burgrp/hw-at32f455-bob/board/at32f455-bob.kicad_pcb

## KiCad design board/at32f455-bob.kicad_pcb (2026-09-07)

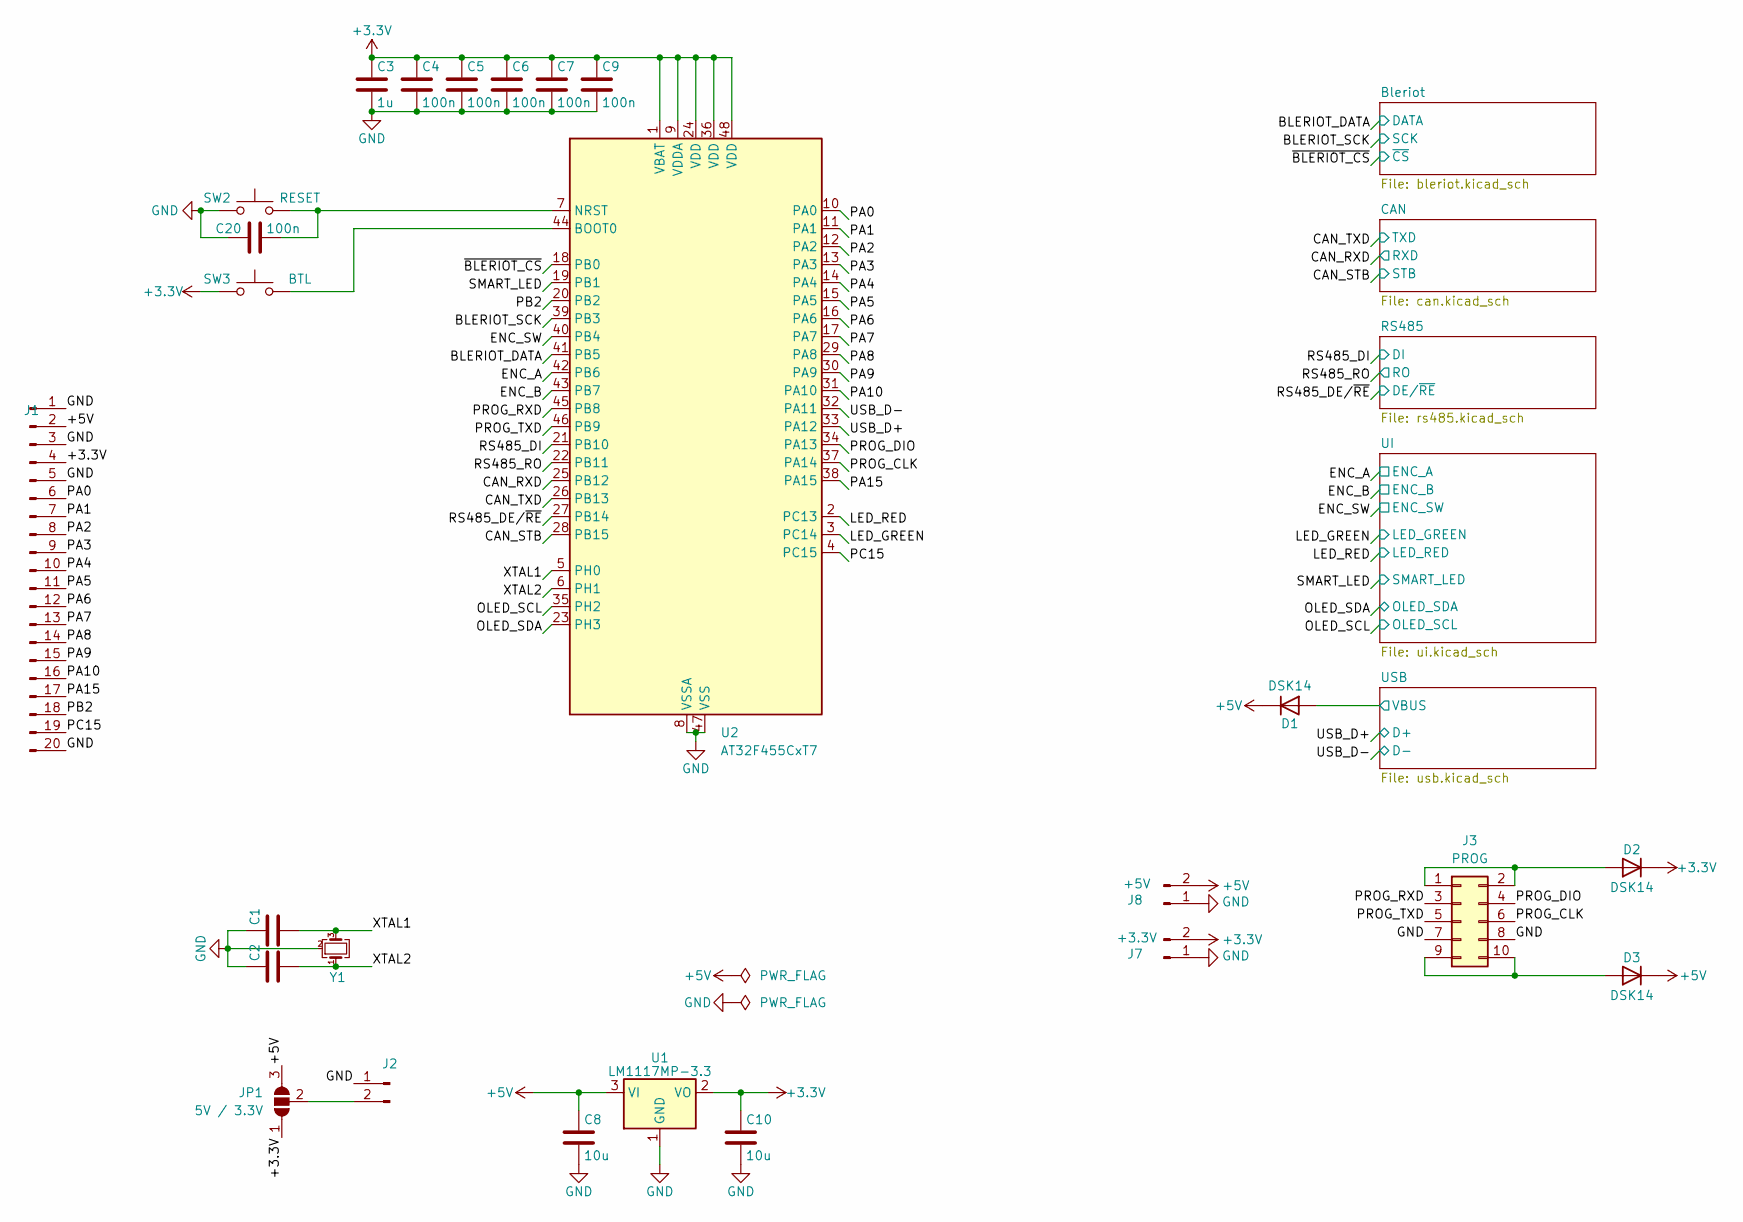
[picture p2: schematic at32f455-bob.kicad_sch]

Parts:
C1, C2: (mcu xtal load); C_0805_2012Metric
C3: 1u; C_0805_2012Metric
C4, C5, C6, C7, C9, C20: 100n; C_0805_2012Metric
C8, C10: 10u; C_0805_2012Metric
D1, D2, D3: DSK14; D_SOD-123
J1: BB; PinHeader_1x26_P2.54mm_Vertical
J2: PWR; PinHeader_1x02_P2.54mm_Vertical
J3: PROG; PinHeader_2x05_P2.54mm_Vertical
J7: +3.3V; PhoenixContact_MC_1,5_2-G-3.5_1x02_P3.50mm_Horizontal
J8: +5V; PhoenixContact_MC_1,5_2-G-3.5_1x02_P3.50mm_Horizontal
JP1: 5V / 3.3V; SolderJumper-3_P2.0mm_Open_TrianglePad1.0x1.5mm
SW2: RESET; SW_PUSH_6mm
SW3: BTL; SW_PUSH_6mm
U1: LM1117MP-3.3; SOT-223-3_TabPin2
U2: AT32F455CxT7; LQFP-48_7x7mm_P0.5mm
Y1: not populated; Crystal_SMD_3225-4Pin_3.2x2.5mm

Connections:
+3.3V: C3.1, C4.1, C5.1, C6.1, C7.1, C9.1, C10.1, D2.1 (K), J1.4, J7.2, JP1.1 (A), SW3.1, U1.2 (VO), U2.1 (VBAT), U2.9 (VDDA), U2.24 (VDD), U2.36 (VDD), U2.48 (VDD); also elsewhere on the board
+5V: C8.1, D1.1 (K), D3.1 (K), J1.2, J8.2, JP1.3 (B), U1.3 (VI); also elsewhere on the board
/BLERIOT_DATA: U2.41 (PB5); also elsewhere on the board
/BLERIOT_SCK: U2.39 (PB3); also elsewhere on the board
/CAN_RXD: U2.25 (PB12); also elsewhere on the board
/CAN_STB: U2.28 (PB15); also elsewhere on the board
/CAN_TXD: U2.26 (PB13); also elsewhere on the board
/ENC_A: U2.42 (PB6); also elsewhere on the board
/ENC_B: U2.43 (PB7); also elsewhere on the board
/ENC_SW: U2.40 (PB4); also elsewhere on the board
/LED_GREEN: U2.3 (PC14); also elsewhere on the board
/LED_RED: U2.2 (PC13); also elsewhere on the board
/OLED_SCL: U2.35 (PH2); also elsewhere on the board
/OLED_SDA: U2.23 (PH3); also elsewhere on the board
/PA0: J1.6, U2.10 (PA0)
/PA1: J1.7, U2.11 (PA1)
/PA2: J1.8, U2.12 (PA2)
/PA3: J1.9, U2.13 (PA3)
/PA4: J1.10, U2.14 (PA4)
/PA5: J1.11, U2.15 (PA5)
/PA6: J1.12, U2.16 (PA6)
/PA7: J1.13, U2.17 (PA7)
/PA8: J1.14, U2.29 (PA8)
/PA9: J1.15, U2.30 (PA9)
/PA10: J1.16, U2.31 (PA10)
/PA15: J1.17, U2.38 (PA15)
/PB2: J1.18, U2.20 (PB2)
/PC15: J1.19, U2.4 (PC15)
/PROG_CLK: J3.6, U2.37 (PA14)
/PROG_DIO: J3.4, U2.34 (PA13)
/PROG_RXD: J3.3, U2.45 (PB8)
/PROG_TXD: J3.5, U2.46 (PB9)
/RS485_DE/~RE: U2.27 (PB14); also elsewhere on the board
/RS485_DI: U2.21 (PB10); also elsewhere on the board
/RS485_RO: U2.22 (PB11); also elsewhere on the board
/SMART_LED: U2.19 (PB1); also elsewhere on the board
/USB/VBUS: D1.2 (A); also elsewhere on the board
/USB_D+: U2.33 (PA12); also elsewhere on the board
/USB_D-: U2.32 (PA11); also elsewhere on the board
/XTAL1: C1.2, U2.5 (PH0), Y1.3
/XTAL2: C2.2, U2.6 (PH1), Y1.1
/~BLERIOT_CS: U2.18 (PB0); also elsewhere on the board
GND: C1.1, C2.1, C3.2, C4.2, C5.2, C6.2, C7.2, C8.2, C9.2, C10.2, C20.1, J1.1, J1.3, J1.5, J1.20, J2.1, J3.7, J3.8, J7.1, J8.1, SW2.1, U1.1 (GND), U2.8 (VSSA), U2.47 (VSS), Y1.2 (G), Y1.4 (G); also elsewhere on the board
unnamed: D2.2 (A), J3.1, J3.2
unnamed: D3.2 (A), J3.9, J3.10
unnamed: J2.2, JP1.2 (C)
unnamed: SW3.2, U2.44 (BOOT0)
unnamed: C20.2, SW2.2, U2.7 (NRST)

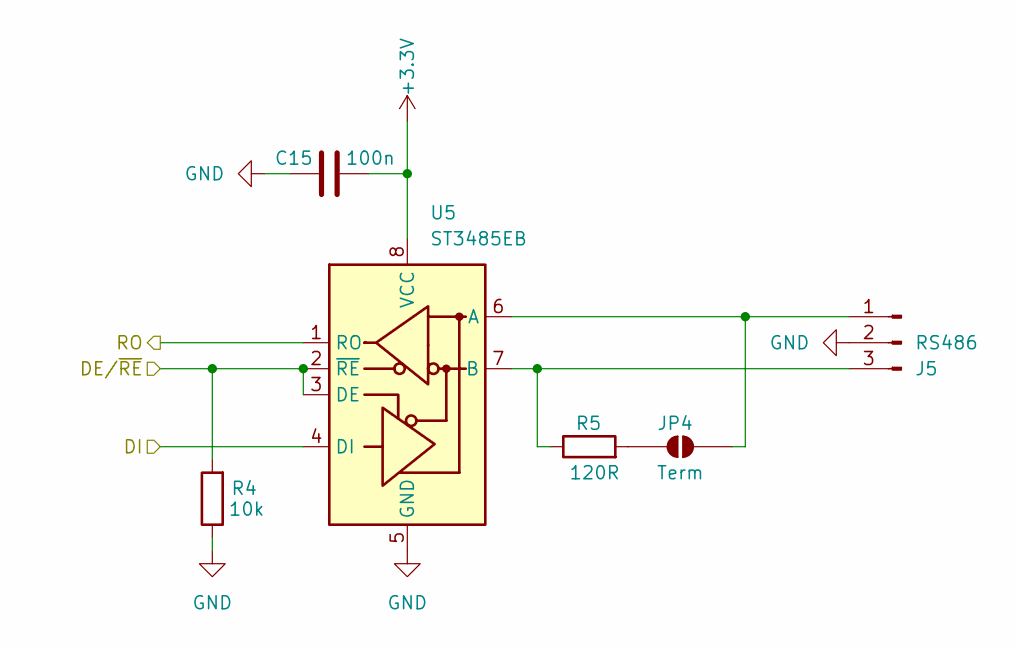
[picture p3: schematic rs485.kicad_sch]

Parts:
C15: 100n; C_0805_2012Metric
J5: RS486; PhoenixContact_MC_1,5_3-G-3.5_1x03_P3.50mm_Horizontal
JP4: Term; SolderJumper-2_P1.3mm_Open_TrianglePad1.0x1.5mm
R4: 10k; R_0805_2012Metric
R5: 120R; R_0805_2012Metric
U5: ST3485EB; SOIC-8_3.9x4.9mm_P1.27mm

Connections:
+3.3V: C15.2, U5.8 (VCC); also elsewhere on the board
/RS485_DE/~RE: R4.2, U5.2 (~RE), U5.3 (DE); also elsewhere on the board
/RS485_DI: U5.4 (DI); also elsewhere on the board
/RS485_RO: U5.1 (RO); also elsewhere on the board
GND: C15.1, J5.2, R4.1, U5.5 (GND); also elsewhere on the board
unnamed: J5.1, JP4.2 (B), U5.6 (A)
unnamed: J5.3, R5.1, U5.7 (B)
unnamed: JP4.1 (A), R5.2

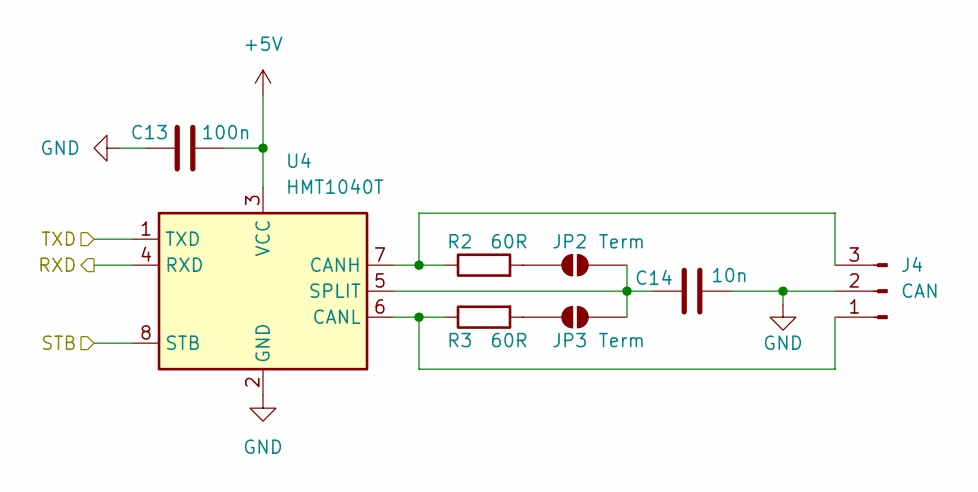
[picture p4: schematic can.kicad_sch]

Parts:
C13: 100n; C_0805_2012Metric
C14: 10n; C_0805_2012Metric
J4: CAN; PhoenixContact_MC_1,5_3-G-3.5_1x03_P3.50mm_Horizontal
JP2, JP3: Term; SolderJumper-2_P1.3mm_Open_TrianglePad1.0x1.5mm
R2, R3: 60R; R_0805_2012Metric
U4: HMT1040T; SOIC-8_3.9x4.9mm_P1.27mm

Connections:
+5V: C13.2, U4.3 (VCC); also elsewhere on the board
/CAN_RXD: U4.4 (RXD); also elsewhere on the board
/CAN_STB: U4.8 (STB); also elsewhere on the board
/CAN_TXD: U4.1 (TXD); also elsewhere on the board
GND: C13.1, C14.2, J4.2, U4.2 (GND); also elsewhere on the board
unnamed: J4.1, R3.1, U4.6 (CANL)
unnamed: J4.3, R2.1, U4.7 (CANH)
unnamed: JP2.1 (A), R2.2
unnamed: C14.1, JP2.2 (B), JP3.2 (B), U4.5 (SPLIT)
unnamed: JP3.1 (A), R3.2

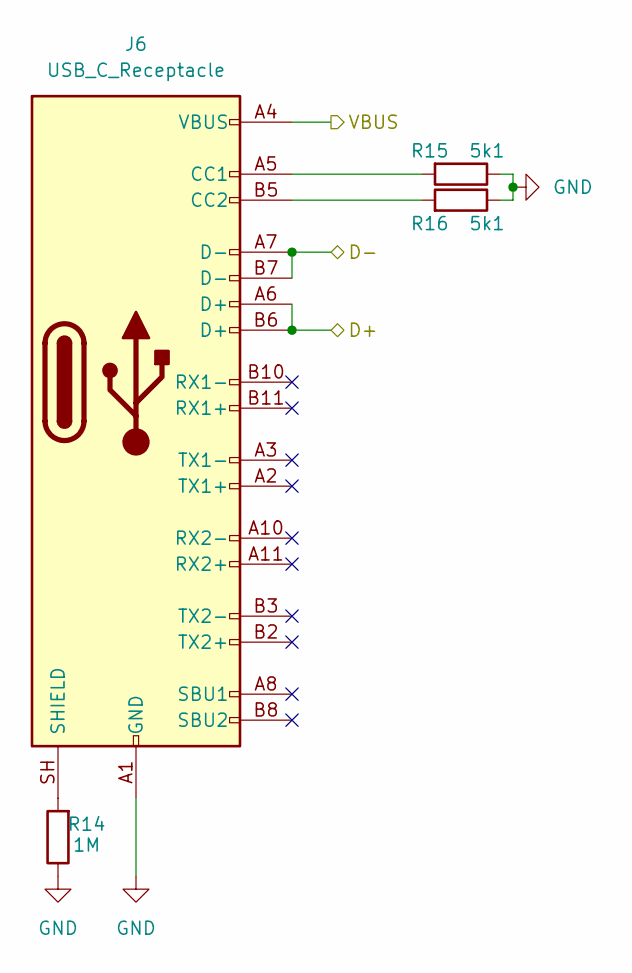
[picture p5: schematic usb.kicad_sch]

Parts:
J6: USB_C_Receptacle; USB_C_Receptacle-Handsolder
R14: 1M; R_0805_2012Metric
R15, R16: 5k1; R_0805_2012Metric

Connections:
/USB/VBUS: J6.A4 (VBUS), J6.A9 (VBUS), J6.B4 (VBUS), J6.B9 (VBUS); also elsewhere on the board
/USB_D+: J6.A6 (D+), J6.B6 (D+); also elsewhere on the board
/USB_D-: J6.A7 (D-), J6.B7 (D-); also elsewhere on the board
GND: J6.A1 (GND), J6.A12 (GND), J6.B1 (GND), J6.B12 (GND), R14.1, R15.1, R16.1; also elsewhere on the board
unnamed: J6.A5 (CC1), R15.2
unnamed: J6.B5 (CC2), R16.2
unnamed: J6.SH (SHIELD), R14.2

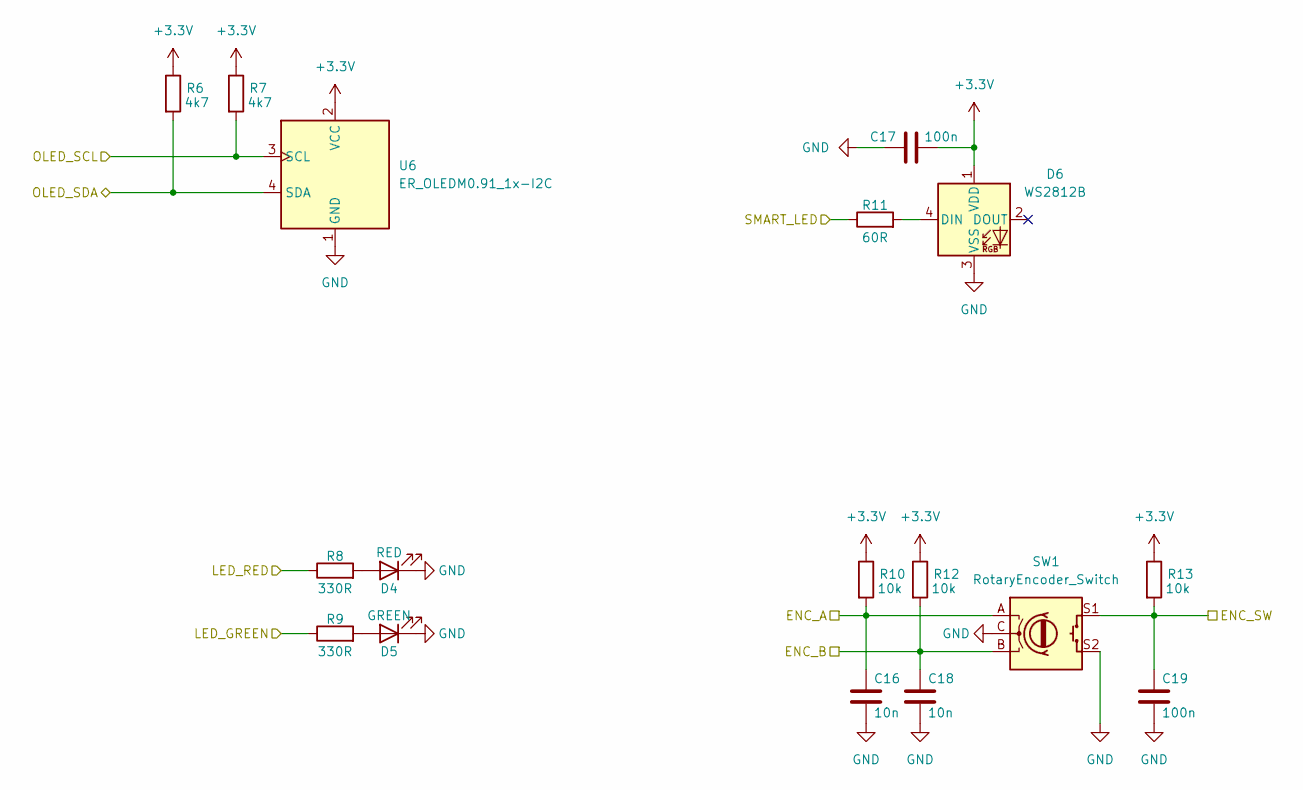
[picture p6: schematic ui.kicad_sch]

Parts:
C16, C18: 10n; C_0805_2012Metric
C17, C19: 100n; C_0805_2012Metric
D4: RED; LED_0805_2012Metric
D5: GREEN; LED_0805_2012Metric
D6: WS2812B; LED_WS2812B_PLCC4_5.0x5.0mm_P3.2mm
R6, R7: 4k7; R_0805_2012Metric
R8, R9: 330R; R_0805_2012Metric
R10, R12, R13: 10k; R_0805_2012Metric
R11: 60R; R_0805_2012Metric
SW1: RotaryEncoder_Switch; RotaryEncoder_Alps_EC11E-Switch_Vertical_H20mm
U6: ER_OLEDM0.91_1x-I2C

Connections:
+3.3V: C17.2, D6.1 (VDD), R6.1, R7.1, R10.1, R12.1, R13.1, U6.2 (VCC); also elsewhere on the board
/ENC_A: C16.2, R10.2, SW1.A; also elsewhere on the board
/ENC_B: C18.2, R12.2, SW1.B; also elsewhere on the board
/ENC_SW: C19.2, R13.2, SW1.S1; also elsewhere on the board
/LED_GREEN: R9.1; also elsewhere on the board
/LED_RED: R8.1; also elsewhere on the board
/OLED_SCL: R7.2, U6.3 (SCL); also elsewhere on the board
/OLED_SDA: R6.2, U6.4 (SDA); also elsewhere on the board
/SMART_LED: R11.1; also elsewhere on the board
GND: C16.1, C17.1, C18.1, C19.1, D4.1 (K), D5.1 (K), D6.3 (VSS), SW1.C, SW1.S2, U6.1 (GND); also elsewhere on the board
unnamed: D4.2 (A), R8.2
unnamed: D5.2 (A), R9.2
unnamed: D6.4 (DIN), R11.2

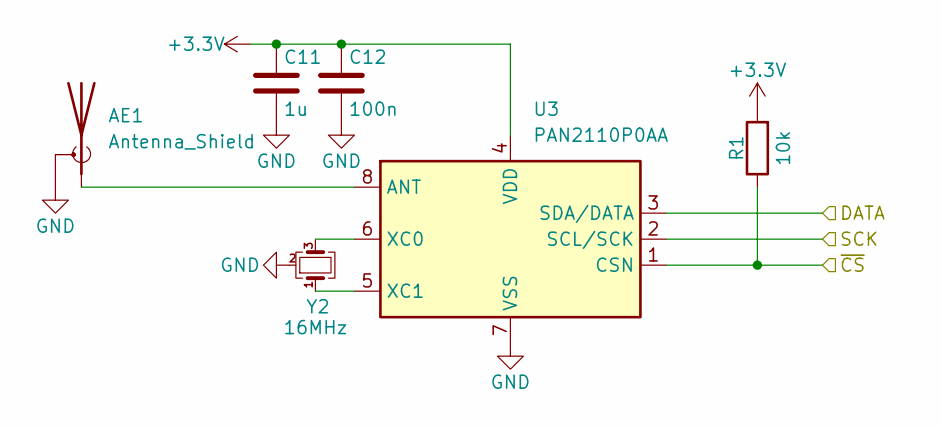
[picture p7: schematic bleriot.kicad_sch]

Parts:
AE1: Antenna_Shield; Texas_SWRA117D_2.4GHz_Right
C11: 1u; C_0805_2012Metric
C12: 100n; C_0805_2012Metric
R1: 10k; R_0805_2012Metric
U3: PAN2110P0AA; SOIC-8_3.9x4.9mm_P1.27mm
Y2: 16MHz; Crystal_SMD_3225-4Pin_3.2x2.5mm

Connections:
+3.3V: C11.1, C12.1, R1.2, U3.4 (VDD); also elsewhere on the board
/BLERIOT_DATA: U3.3 (SDA/DATA); also elsewhere on the board
/BLERIOT_SCK: U3.2 (SCL/SCK); also elsewhere on the board
/~BLERIOT_CS: R1.1, U3.1 (CSN); also elsewhere on the board
GND: AE1.2 (Shield), C11.2, C12.2, U3.7 (VSS), Y2.2 (G), Y2.4 (G); also elsewhere on the board
unnamed: AE1.1 (A), U3.8 (ANT)
unnamed: U3.6 (XC0), Y2.3
unnamed: U3.5 (XC1), Y2.1

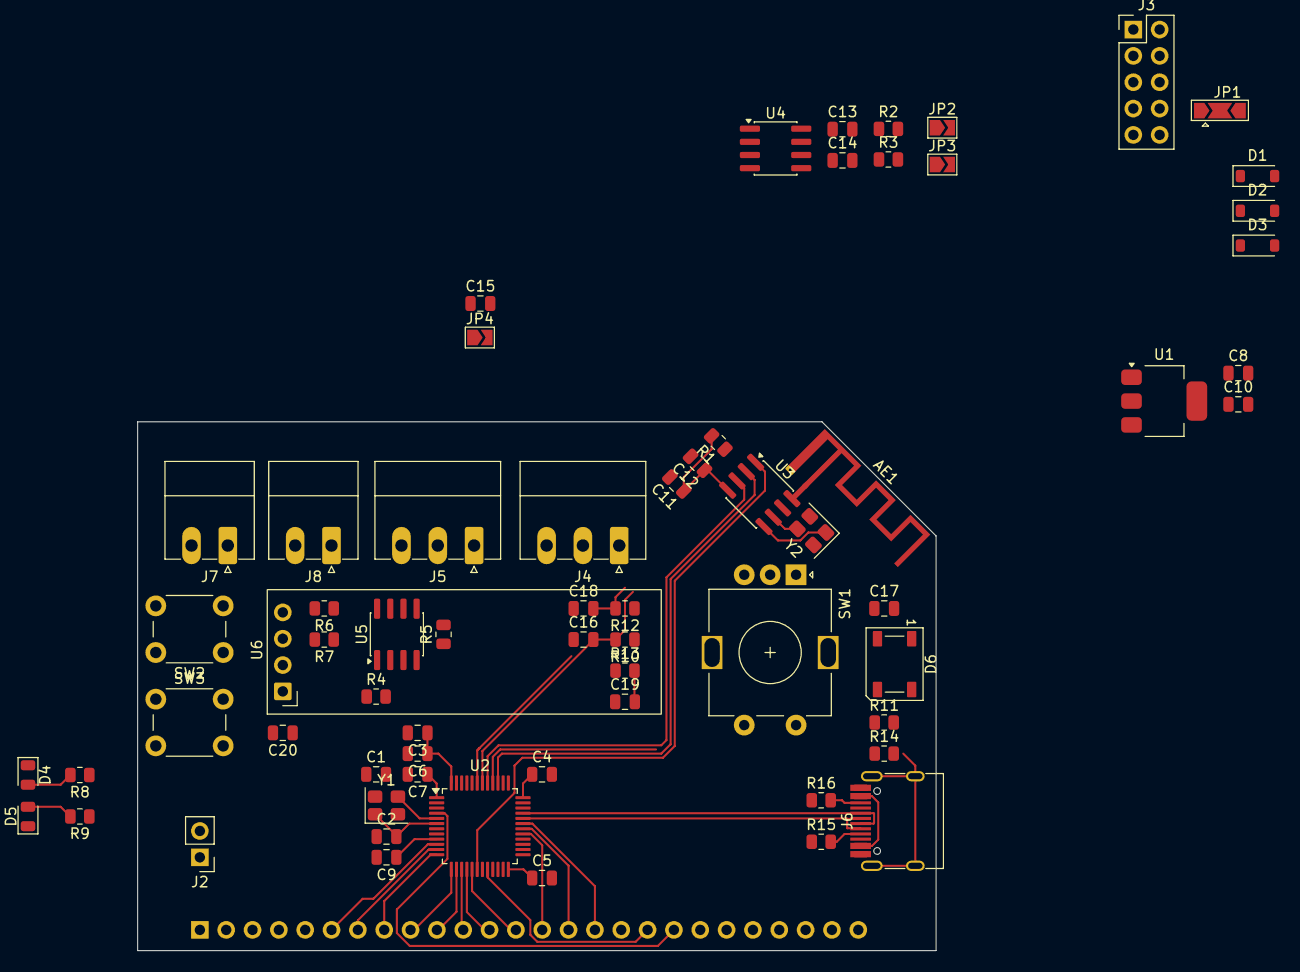
[picture p8: board at32f455-bob.kicad_pcb from above]

Board: 2 copper layers, 77.0 x 51.0 mm, 66 parts (1 on the bottom side), 65 nets.
